fenilnig/G.R.E.M/cad/assembly/grem_full_assembly.step

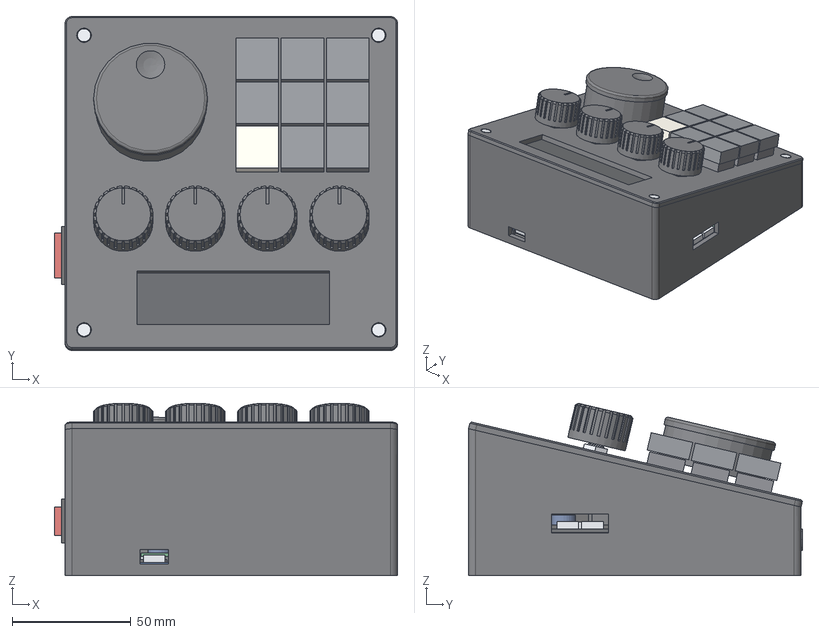
[picture p1: CAD file, 2026-10-22]
cad/assembly/grem_full_assembly.step
144.5 x 140.6 x 72.6 mm
Body (printed)
Foam pad - battery holder
Foam pad - TP4056
Foam pad - XL6009
18650 holder base
18650 holder end wall -
18650 holder end wall +
18650 holder rail rear
18650 holder rail front
18650 cell
TP4056 PCB
TP4056 USB-C port
TP4056 chips
XL6009 PCB
XL6009 inductor
XL6009 trimmer
XL6009 capacitor
XL6009 IC
Rocker switch body
Rocker bezel
Rocker rocker
Standoff 1 (M3 F-F, 5)
Floor screw 1 (M3x6)
Standoff 2 (M3 F-F, 5)
Floor screw 2 (M3x6)
Standoff 3 (M3 F-F, 5)
Floor screw 3 (M3x6)
Standoff 4 (M3 F-F, 5)
Floor screw 4 (M3x6)
Main board (perfboard)
ESP32 socket rear
ESP32 socket front
ESP32-S3 PCB
ESP32 shield
ESP32 USB-C x2
ESP32 buttons
MCP23017 breakout (assumed 35 x 22)
MCP23017 headers
DRV2605L breakout
DRV2605L headers
Capacitor 100nF #1
Capacitor 100nF #2
Capacitor 100nF #3
Capacitor 100nF #4
Capacitor 100nF #5
Capacitor 100nF #6
Resistor #1
Resistor #2
Resistor #3
Resistor #4
Bulk capacitor
Post insert 1 (M3)
Post insert 2 (M3)
Post insert 3 (M3)
Post insert 4 (M3)
Top plate (printed)
OLED glass
OLED PCB
OLED header
OLED insert LR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
