fenilnig/G.R.E.M/cad/stl/grem_knob_large_x1_use.stl

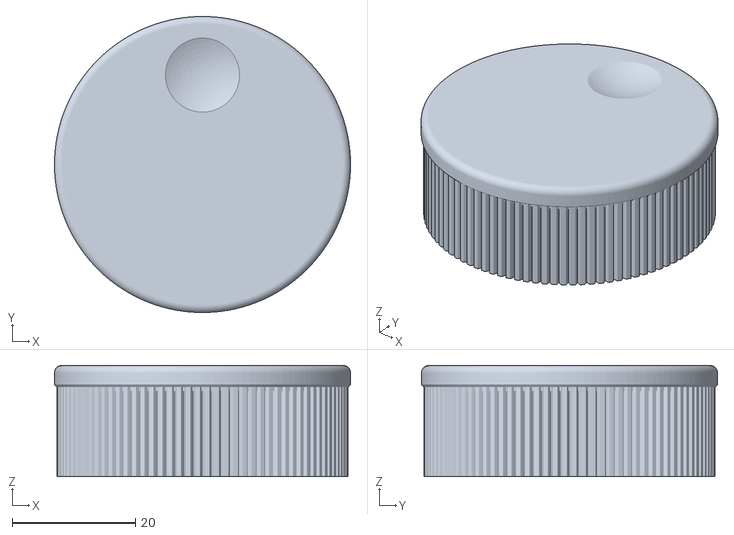
[picture p3: CAD file, 2026-10-22]
cad/stl/grem_knob_large_x1_use.stl
48.0 x 48.0 x 18.0
