fenilnig/G.R.E.M/cad/step/grem_knob_small_x4.step

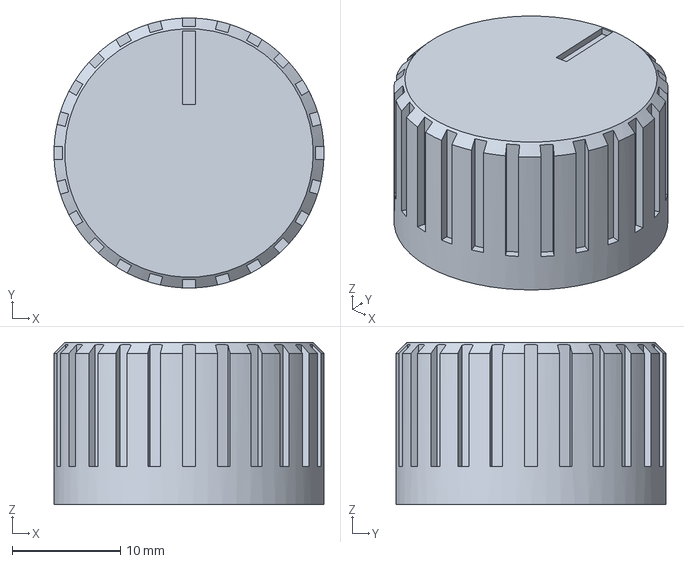
[picture p4: CAD file, 2026-10-22]
cad/step/grem_knob_small_x4.step
25.0 x 25.0 x 15.0 mm
