fenilnig/G.R.E.M/cad/step/grem_top_plate.step

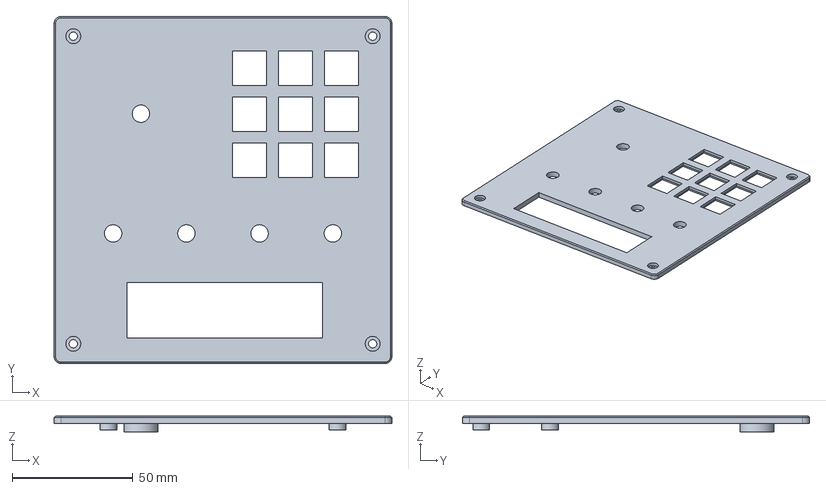
[picture p5: CAD file, 2026-10-22]
cad/step/grem_top_plate.step
140.0 x 143.8 x 6.50 mm
