fenilnig/G.R.E.M/cad/step/grem_test_knob_stubs.step

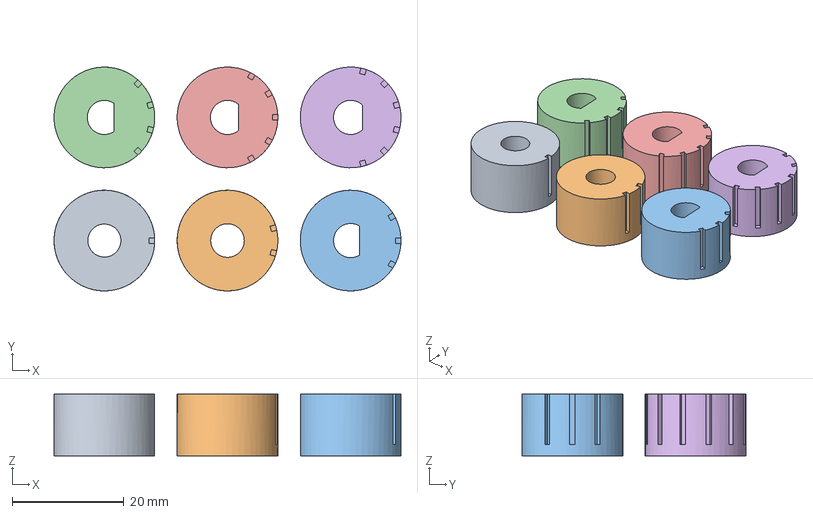
[picture p6: CAD file, 2026-10-22]
cad/step/grem_test_knob_stubs.step
62.0 x 40.0 x 11.0 mm
