fenilnig/G.R.E.M/cad/step/grem_test_tile.step

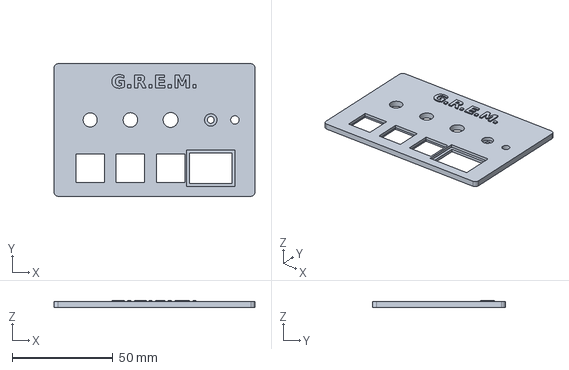
[picture p7: CAD file, 2026-10-22]
cad/step/grem_test_tile.step
100.0 x 66.0 x 3.59 mm
