fenilnig/G.R.E.M/cad/step/grem_knob_large_x1.step

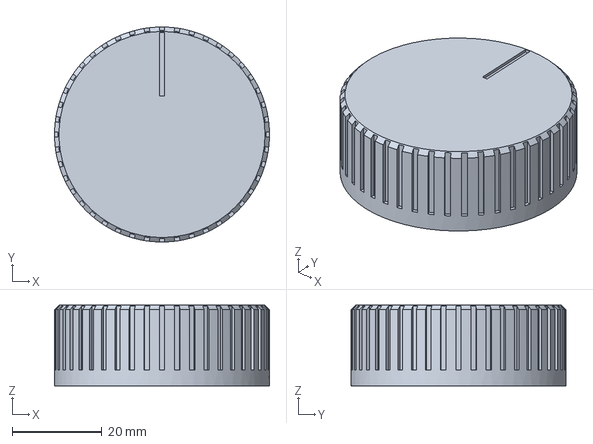
[picture p8: CAD file, 2026-10-22]
cad/step/grem_knob_large_x1.step
48.0 x 48.0 x 18.0 mm
