fenilnig/G.R.E.M/cad/step/grem_body.step

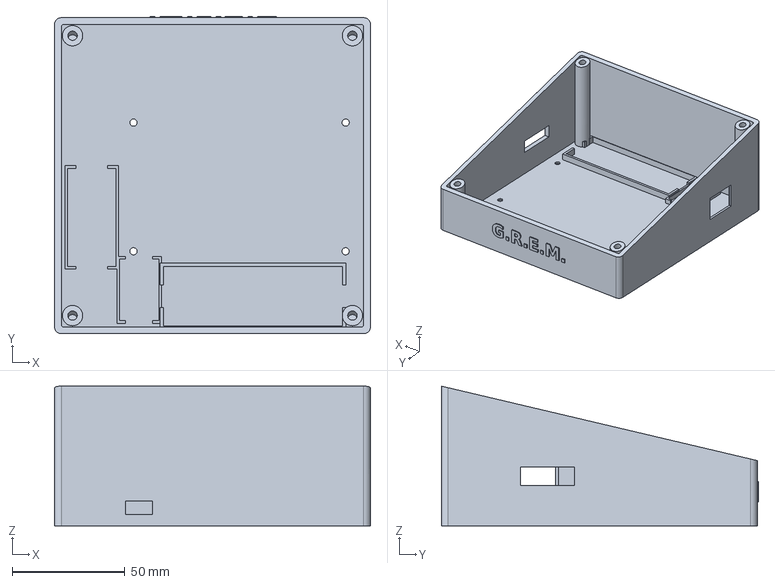
[picture p9: CAD file, 2026-10-22]
cad/step/grem_body.step
140.0 x 140.6 x 61.9 mm
