fenilnig/G.R.E.M/(list of files, cad)

Other CAD files:
cad/assembly/grem_full_assembly.stl
cad/stl/grem_body.stl
cad/stl/grem_knob_large_x1.stl
cad/stl/grem_knob_large_x1_simple.stl
cad/stl/grem_knob_small_x4.stl
cad/stl/grem_test_knob_stubs.stl
cad/stl/grem_test_tile.stl
cad/stl/grem_top_plate.stl
