fenilnig/G.R.E.M/cad/assembly/grem_render_assembled.png

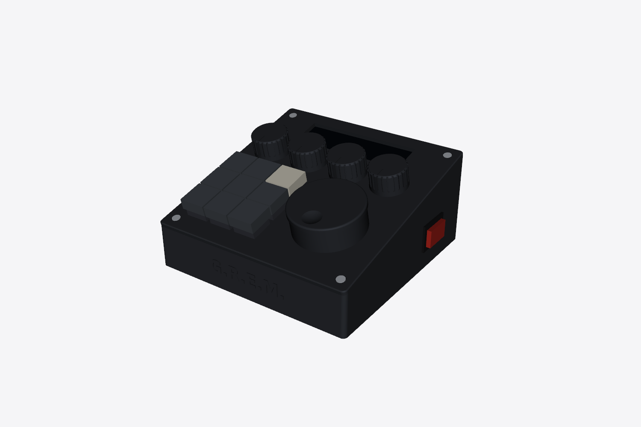
cad/assembly/grem_render_assembled.png
