fenilnig/G.R.E.M/cad/assembly/grem_render_inside_top.png

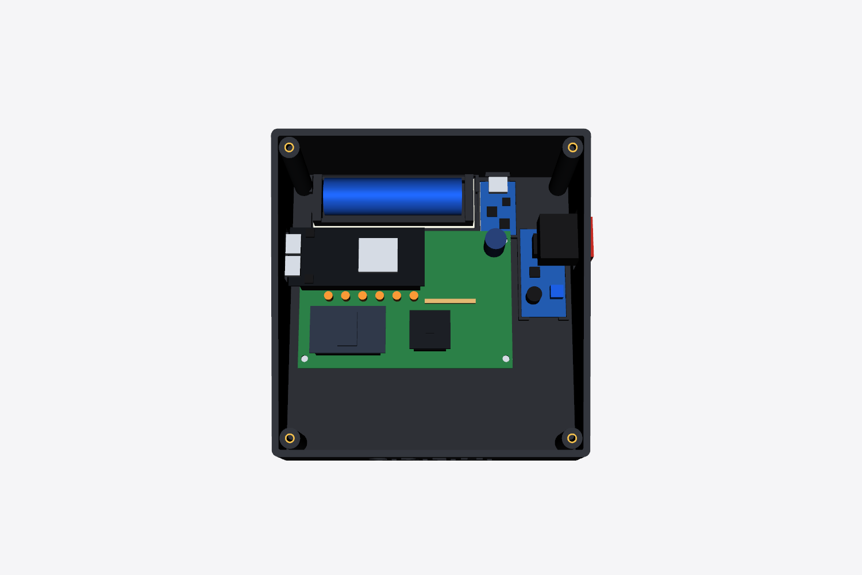
cad/assembly/grem_render_inside_top.png
