fenilnig/G.R.E.M/cad/assembly/grem_render_lid_lifted.png

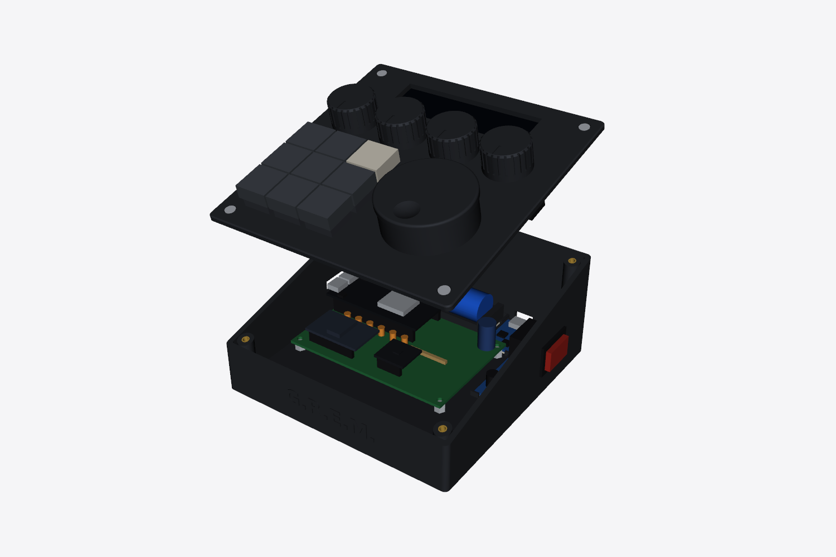
cad/assembly/grem_render_lid_lifted.png
