fenilnig/G.R.E.M/cad/assembly/grem_render_rear.png

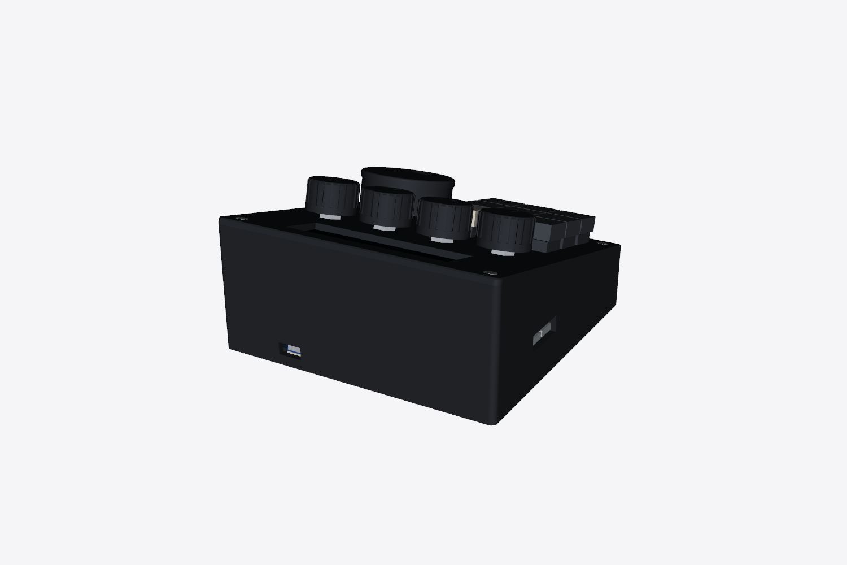
cad/assembly/grem_render_rear.png
