fenilnig/G.R.E.M/(commit log)

2026-10-22 Add G.R.E.M. CAD, firmware and docs
    Printable STL/STEP, full assembly, CadQuery source, PlatformIO firmware
    (4 stages), parts list, wiring list and bench-test checklist.
    Claude-Session: https://claude.ai/code/session_01Wu7bQmXjfUo54voePTar4V
    [grem_assembly_BOM.csv, grem_body.step, grem_body.stl, grem_full_assembly.step, grem_full_assembly.stl, grem_knob_large_x1.step, grem_knob_large_x1.stl, grem_knob_small_x4.step]
2026-10-22 Add desk-buddy mode (stage 5)
    Animated eyes, sleep/wake behaviour and a focus/break timer using the
    existing OLED, dials and haptic motor. No new hardware.
    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
2026-10-22 Add PC companion, editable key map, dash and auto profiles (stage 6)
    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
2026-10-22 Fix build: hand-built BLE HID service, TinyUSB flags
    NimBLEHIDDevice's header clashes with the USB library (HID_SUBCLASS_NONE).
    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
    [hid_out.h]
2026-10-22 Big dial knob enlarged to 48 mm x 18 mm, 44 grooves
    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
    [grem_knob_large_x1.step, grem_knob_large_x1.stl]
2026-10-22 Sync CAD, assembly, blueprint and docs to 48 mm big knob / 25 mm small knobs
    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
    [grem_full_assembly.step, grem_full_assembly.stl, grem_knob_large_x1.step, grem_knob_small_x4.step, grem_knob_small_x4.stl, parts_list.csv]
2026-10-22 Layout Rev D: 140x140 body, 12 mm margins, re-spaced dials/keys/big knob, blueprint updated
    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
    [grem_assembly_BOM.csv, grem_body.step, grem_body.stl, grem_full_assembly.step, grem_full_assembly.stl, grem_knob_large_x1.step, grem_knob_small_x4.step, grem_test_knob_stubs.step]
2026-10-22 Big knob: diamond-knurled 48 mm design; blueprint now uses real CAD meshes; test print zip updated
    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
    [grem_knob_large_x1.stl, grem_knob_large_x1_simple.step, grem_knob_large_x1_use.stl, parts_list.csv]
2026-10-22 Assembly CAD uses knurled-knob stand-in (same envelope); sync
    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
    [grem_full_assembly.step, grem_full_assembly.stl, grem_knob_large_x1_simple.step, grem_knob_large_x1_simple.stl]
2026-10-22 Big knob redesigned to match Ender 3 diamond knurl (flat top, base ring); blueprint, assembly, test zip updated
    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
    [grem_full_assembly.step, grem_full_assembly.stl, grem_knob_large_x1.stl, grem_knob_large_x1_simple.step, grem_knob_large_x1_simple.stl, grem_knob_large_x1_use.stl]
2026-10-22 Remove obsolete plain-cylinder big knob STEP (replaced by knurled design + simple stand-in)
    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
    [grem_knob_large_x1.step]
2026-10-22 Big knob redesigned to match Ulanzi-style dial: fine straight ridges, flat cap, finger dimple; all CAD synced
    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
    [grem_full_assembly.step, grem_full_assembly.stl, grem_knob_large_x1.step, grem_knob_large_x1.stl, grem_knob_large_x1_simple.step, grem_knob_large_x1_simple.stl, grem_knob_large_x1_use.stl, parts_list.csv]
